peter-mowen/networked-environment-monitor/img/prototype/protoboard-modules.jpg

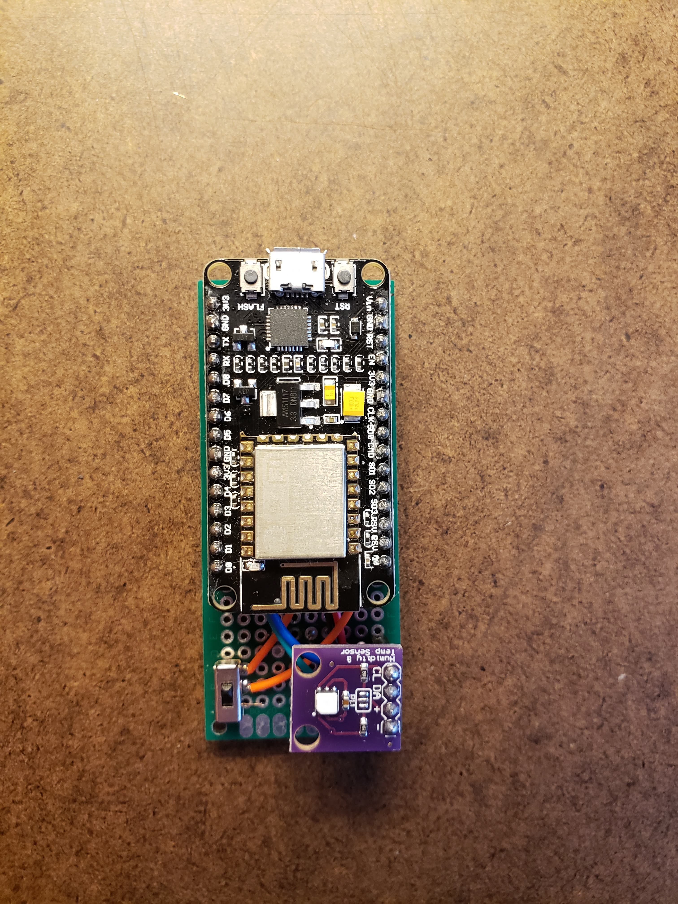
img/prototype/protoboard-modules.jpg
