peter-mowen/networked-environment-monitor/README.md

# Networked Thermometer

## Description
The Networked Thermostater reads the local temperature and reports it via MQTT.

Note that there are a few custom classes in this repository. Eventually, these
will be broken out into their own repos, but for now they are housed here. The
custom classes are:
- HomeNode: handles MQTT
- Si7021: handles I2C communication with si7021 chip. Only supports reading
    temperature at this time
- Thermometer: uses the Si7021 class and Homenode class to read temperature and
    send it via MQTT

NetworkedThermoter.ino calls the setup functions and loop functions for each
class, so the heavy lifting is done in the code for the classes, not the .ino
file.

NetworkedThermoter is setup to turn-on, setup everything, take a temperature
reading and send it via MQTT, then put itself into a deep sleep for 10 minutes,
rinse and repeat.

### Parts
- ESP-12e: microcontroller around which everything is built
- si7021 Humidity and Temperature sensor
- Protoboard
- Wires

### Hardware Setup
Make the following connections between the ESP-12e module and the si7021 module:

| ESP-12e | si7021 |
|:---:|:---:|
| D1 | CL |
| D2 | DA |
| 3.3V | + |
| GND | - |

For deep sleep to work, D0 must be connected to RST. However, this connection
makes it so you cannot load new code onto the module. To get around this, I
added a small SPDT switch with one side connected to D0, the middle connected to
RST, and the other side disconnected. Flipping the switch to one side connects
D0 to RST, while flipping it to the other breaks this connection.

See img/prototype for wiring on breadboard and protoboard.

### Getting Code onto the ESP8266
- Download this repo to your local machine. It will have the custom classes
already included
- Put the NetworkedThermometer folder in your Arduino folder (default location
    is ~/Arduino)
- Open the NetworkedThermoter.ino file with the Arduino IDE
- Add the ESP8266 module to your Arduino IDE
- Connect the ESP-12e module to your computer
- Load the sketch to the ESP-12e using the Arduino IDE

### Dependencies
The following is a list of libraries which this sketch uses as well as a short
description:
- PubSubClient - enable MQTT communication
- Wire - needed for I2C communication

### Node-RED Flows
I used node-RED to create a flow for monitoring the MQTT network and adding
reported temperatures to a database running on a Raspberry Pi. Though that code
is not part of this repository, an image of the user interface can be found in
the img folder.
