peter-mowen/networked-environment-monitor/img/node_red-ui.png

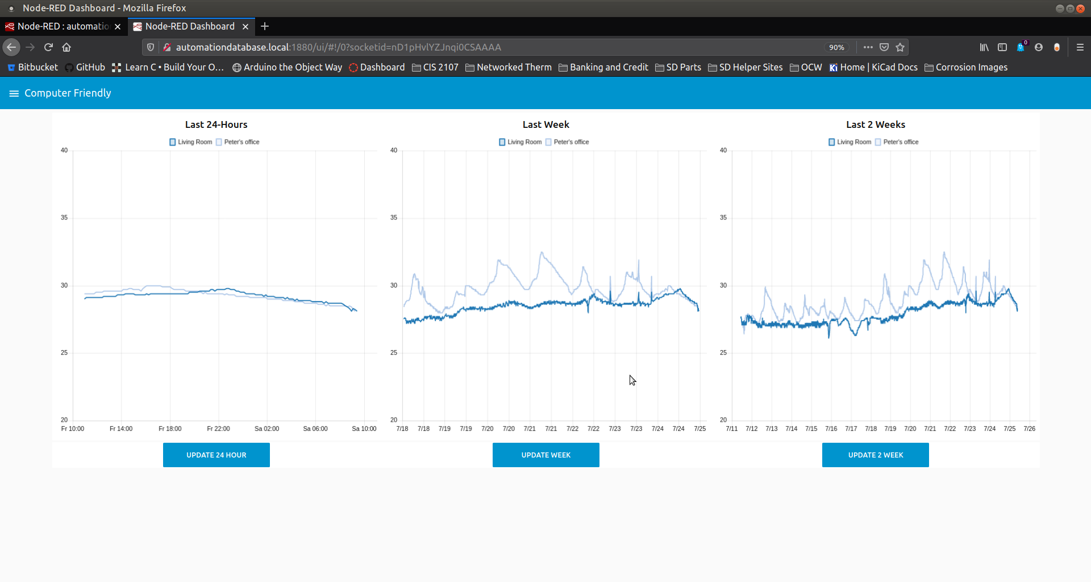
img/node_red-ui.png
