peter-mowen/networked-environment-monitor/img/prototype/breadboard.jpg

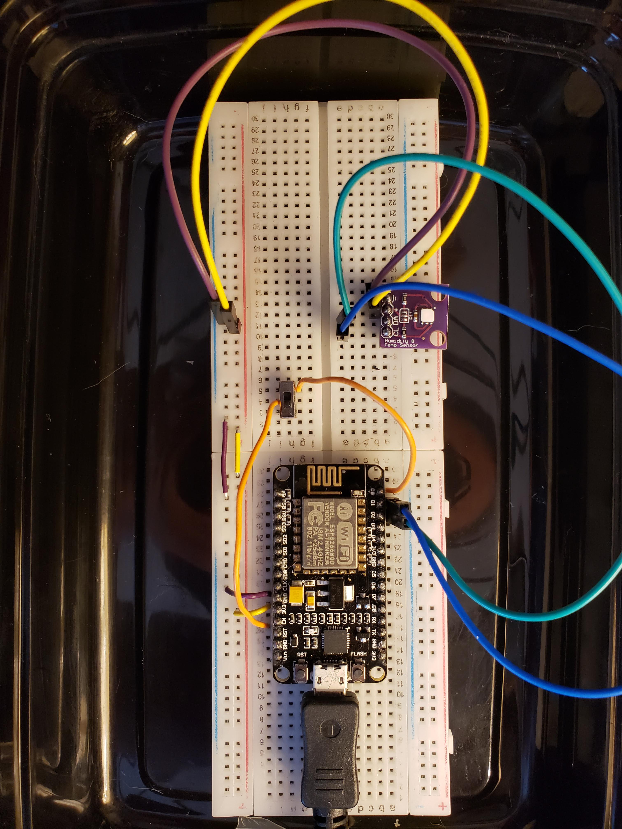
img/prototype/breadboard.jpg
