peter-mowen/networked-environment-monitor/(commit log)

2019-07-24 Initial commit
    Copied code from EnvironmentMonitor and commented out everything related
    to the LDR and LCD. I'm moving development of that project from the
    Arduino to the esp8266-12e. References to the LDR were commented-out for
    the time being until I get a better grasp of the I/Os for the
    esp8266-12e. References to the LCD were commented out because I will
    need to use a different LCD library with the esp8266-12e and having the
    old references breaks the code.
2019-07-24 Fixed accuracy of readTemperature()
    Added an offset for the ADC value. The temperatures read by the
    esp8266-12e were about +5C from the temperatures read by the Arduino.
    After some research, I found that it is a known problem that the ADC on
    NodeMCU's boards are not accurate. To compensate, I setup a voltage
    divider with two 1k resistors and measured the voltage between them.
    It was 1.65V, which is half of 3.3V, which is what I expected. The ADC
    value was 543 when it should have been 512. To find the offset, I took
    543-512 = 31 and defined the ADC_OFFSET to be 31. This brought the
    temperature reading close to what I was seeing on the Arduino.
    Furthermore, I changed readTemperature() to get 1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
    [NetworkedEnvironmentMonitor.ino]
2019-07-25 Deleted printToSerial(.) and added publishData(..)
    Since the networked version of this sketch does not transmit data
    through serial, I removed the function that did that. In its place, I
    wrote a function to publish data to the mqtt broker using pubsubclient.
    I also copied a bunch of code/helper functions from the pubsubclient
    esp8266 example to make it work. Yay plumbing!
    TODO: change inputs to publishData function so that it accepts a
    multidimensional array of topics and data instead of two arguments, one
    for topic and the other for data.
    [NetworkedEnvironmentMonitor.ino]
2019-08-05 Removed references to LCD. Added setup for OLED
    Commented-out everything related to LCD. Copied the include statements,
    constants, and setup portion from the Arducam_ssd1306_128x64_I2C.ino
    example program that came with the library. Changed the position and
    contents of the text so that it will print the clientID name in the
    top portion of the screen where there are yellow pixels.
2019-08-06 Added OLED support for displaying temperature
    Changed printDataToLCD to printDataToOLED in all places. Updated
    function to print data to the OLED. Moved the code to display the
    heading (room name) into the printDataToOLED function since the whole
    display has to be refreshed when the temperature is updated.
2019-08-08 Added code to select channel on multiplexer
    Since the esp8266 has only one analog input, I added a multiplexer IC,
    the cd4051b. The temperature sensor is wired to channel 0. One problem
    I ran into when setting up this chip is that I forgot to wire INH
    (inhibit) to ground so that it would read a zero. Without that, the IC
    does not let channel-in go to channel-out. Used a switch statement to
    set the states of the digital out pins connected to the channel select
    pins on the cd4051b. Added cases for channel 0 and channel 1.
    [NetworkedEnvironmentMonitor.ino]
2019-08-08 Added code to read ldr and calculate resistance
    Added the hardware for the LDR and connected it to channel 1 of the
    cd4051b. Added readLightLevel() to read light level. Added code in setup
    and loop to read and publish the ldr resistance.
2019-08-09 Changed display to round temperature
    Use to truncate temperature, now it rounds it.
2019-08-09 Created loading screen
    Changed boot-up behavior to provide updates on the sceen. It prints
    "Starting.." in the yellow section and a message stating to which
    network it is trying to connect. Will probably not work as expected if
    trying to connect to the wrong network but this is a start.
    [NetworkedEnvironmentMonitor.ino]
2019-08-09 Added IP address to boot-up display
    After the SSID and connecting messages, the device's IP address gets
    printed to the display and stays there for two seconds.
2019-08-09 Added MQTT updates to boot-up display
    Clear the screen by printing a black rectangle to it. Then move the
    cursor back to the top of the blue text block. Lets user know it's
    trying to connect to the mqtt broker at a certain IP address. Lets user
    know when it's connected. Waits 2 seconds.
    [NetworkedEnvironmentMonitor.ino]
2019-08-09 Added error handling for connecting to WiFi
    Set the max number of attempts to 20 because that is how many periods
    will fit across the OLED and I have yet to see it take more than 15.
    Created a function to handle errors called haltOnError. It accepts
    a string, prints it to the serial port, displays the message to the
    screen, then feeds the watchdog forever.
    [NetworkedEnvironmentMonitor.ino]
2019-08-09 Added error handling for connecting to mqtt broker
    Prints message if the board fails to connect to the mqtt broker. Retries
    5 times at 5 second intervals. Passes error message to haltOnError.
    Updated halt on error to clear display, print "ERROR" in the yellow
    text part, and print the error in the blue text part.
    [NetworkedEnvironmentMonitor.ino]
2019-08-09 Added clearAndWriteToTitle(String title)
    Clears the title area by writing a black rectangle to it, then writes
    the title. Text size is set to 2. Changed all places in the code where
    I manually udpated that section of the display to use this new function.
    Causes "Temp:..." to blink in the printDataToOLED function. Hopefully
    that will be fixed by functionalizing the part that writes text to the
    body.
    [NetworkedEnvironmentMonitor.ino]
2019-08-09 Updated multiplexer pin initialization
    Changed setup function so it just sets the pinMode for each multiplexer
    channel pin. The state is set by the readTemperature or readLightLevel
    function.
2019-10-01 Updated code to work with mcp3008
    Replaced all of the multiplexer and ADC code with calls to the mcp3008
    ADC IC. Debugged hardware. Found that because the temperature sensor was
    near the USB cable, it was getting bad readings, except when I connected
    a multimeter to it. Moved it to the other end of the breadboard and the
    mcp3008 is getting accurate readings now.
    [NetworkedEnvironmentMonitor.ino]
2019-10-09 Squashed commits related to documentation
    These are in reverse chronological order from the order in which they
    occured.
    This is the commit message #8:
    Finished documenting functions
    Added comments that explain what the last few functions do.
    This is the commit message #7:
    Updated README
    Realized I forgot to include the screen in my parts list. Added a
    section on future updates.
    This is the commit message #6:
    Added a README
    This is the commit message #5:
    Updating documentation
    WIP: Added comments to beginning of most of the functions. Added
    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
    [NetworkedEnvironmentMonitor.ino]
2020-01-02 Renames main code and updates README
    Renames main code to better reflect what this code actually is. The
    scope of the project changed. Instead of building an environment monitor
    with lots of different sensors, this is just going to be a thermostat.
    Uncommented preprocessor definitions for debugging. Uncommented sections
    of code to allow network connectivity again. Removed SSID, password, and
    MQTT broker address from commit.
    Updated README to reflect changes to project scope. Also added a Build
    Instructions section and a Dependencies section.
2020-01-03 Updates basic Wifi error handling
    Previously, if the thermostat could not connect to wifi, it errored out
    and hung there. Now, if it cannot connect to wifi, it will not attempt
    to connect to the MQTT broker in the setup block and will not try to
    send the temperature to the broker in the loop block. If the wifi is
    connected and the client is connected to the data broker, it will send
    the temperature to the datat broker. It periodically tries to reconnect
    to the wifi network. Adds symbols to show wifi connectivity in the upper
    right-hand corner of the screen based on wifi status from the last time
    it checked. It does not continuously check wifi status.
2020-01-03 Updates error handling for connecting to mqtt
    Previously, if the thermostat could not connect to the mqtt broker, it
    error-ed out after the max attempts had been reached. Now it will retry
    to connect to the mqtt broker at a given interval. If it cannot connect,
    it still reads and displays the temperature. Also added a symbol that
    shows-up on the display to the left of the wifi symbol to show
    whether or not the thermostat is connected to the mqtt broker. Tested
    the following cases:
    - no wifi
    - wifi but no broker
    - connected to wifi and broker disappears
    - connected to wifi and wifi disappears
    The thermostat was able to reconnect to wifi and the mqtt broker if
    either disappeared, then re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
2020-01-06 Adds local thermostat functionality
    Adds the function "setBoiler" that takes a temperature as an input and
    toggles the boiler based on the input temperature, the desired
    temperature, and the upper and lower bounds around the desired
    temperature. It will turn-on the relay pin if the temperature drops
    below the desired temperature minus the lower bound. The relay pin stays
    high until the temperature reaches the desired temperature plus the
    upper bound, then it turns off. It stays off until the temperature drops
    below the desired temperature minus the lower bound.
    Tested this functionality by hard coding a desired temperature based on
    the ambient temperature in the space I was working (it was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
2020-01-07 Changes temperature sensor to SI7021
    Updates code to support the SI7021. Removes the ADC code and the code to
    read the analog thermistor value. Only reading temperature from the
    SI7021 so far. Updates README to reflect this change. Also fixes some
    errors in README referencing this project by its old name.
2020-01-07 Updates network error handling display
    Makes network error handling a little less "in your face." Instead of
    printing detailed messages to the OLED when trying to connect to wifi or
    the MQTT broker:
    - Wifi symbol flashes on and off while trying to connect
    - A question mark appears where the MQTT symbol should be while it
    is attempting to connect.
    To display detailed network troubleshooting messages, one now has to
    uncomment the preprocessor definition DEBUG_NETWORK.
2020-01-07 Adds desired temperature to OLED display
    The desired temperature is now displayed on the OLED. Updates the
    printTempToOLED function to handle more than one location.
2020-01-07 Adds up and down button support
    The preferred temperature can now be set using two buttons.
    Also, fixes a couple of DEGBUG_NETWORK to DEGBUG_NETWORK and adds a few
    lines to the wifi debug block in the loop section.
2020-01-08 Fixes network connectivity bug and adds relay msg
    Puts the reconnect function before testing the mqtt connection. When my
    test period was only 1 second, the ESP would stay connected to the mqtt
    broker between loops. However, once I started doing longer periods, it
    did not. This commit runs the reconnect function before testing the mqtt
    connection status.
    The previous way was confusing because the indicator on the screen said
    that I was connected to mqtt when in fact I was not. So I was very
    confused as to why the mqtt broker was not receiving anything even
    though the screen said the thermostat was connected.
    This commit also adds mqtt messages to indicate the status of the relay
    which impl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
2020-01-08 Updates how and when on-screen temp is updated
    Changes code to update screen once a minute while updating MQTT onces
    every three minutes. Changes temperature to be a global variable, which
    changes how readAmbientTemperature and printTempToOLED work.
2020-01-08 Changes set temperature behavior
    Now when the set temperature changes, the thermostat checks to see if
    the relay needs to be turned on or off. Uncovered bug where I forgot to
    initialize the button states in the setup block.
2020-01-08 Sends preferred temperature to mqtt broker
2020-01-10 Moves network connectivity check inside reconnect
    I was having trouble with the thermostat staying connected to the mqtt
    broker. I found that I had forgotten to include the reconnect/loop
    structure at the top of my loop function. This commit moves the network
    connectivity check inside the reconnect function so that before trying
    to connect to the mqtt broker, it first checks whether or not it is
    connected to wifi. This significantly cleans-up the main loop function.
    Also, this commit changes how some of the debug statements related to
    network connectivity work. I move all of the serial debug print
    statements into their own DEBUG blocks and moved statements that print
    to the OLED into DEBUG_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
2020-03-22 Starts refactor. Adds Thermometer.cpp. Guts .ino
    The original file, NetworkedThermostat.ino has become unreadable so a
    refactor is in order. This commit starts that process. The goal of the
    refactor is to make the code more modular. Since the room nodes will
    share a large code base with the thermostat, it is prudent to refactor
    the code in such a way as to make that easy. At the end of this
    refactor, there will be two main objects: Thermometer and Thermostat.
    This commits starts the Thermometer object. Thermometer.ccp is a class
    file. This commit adds the ability to create a Thermometer object,
    connect the esp8266 to the si7021 chip via I2C, and read the ambient
    temperature. NetworkedThermo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
2020-03-26 Adds getTemperatureVal() to Thermometer.cpp
    Function to retrieve value of the private data member temperature.
    Updates NetworkedThermostat.ino to use this function when printing the
    temperature to serial to test functionality.
2020-03-26 Adds setupSi7021() to Thermometer.cpp
    Adds privat function to setup I2C connection to the si7021 temperature
    sensor. Changed the setup() function to call this function during setup.
2020-03-27 Adds publishing functionality to Thermometer
    Also updates the HomeNode object and .ino file. Biggest thing I learned
    tonight was to use IPAddress instead of const char* when assigning the
    IP address of the MQTT broker. Using the later is unreliable when trying
    to connect to the broker.
    [HomeNode.cpp, Thermometer.cpp]
2020-08-08 Adds new Si7021 object
    New object handles reading temperature from Si7021 to its own object
    instead of making that part of the Thermometer object. Would like to
    eventually update thermometer to support other temperature sensors.
    As long as the sensor objects have a readTemperatureC function, not much
    would have to change in the thermometer object.
2020-08-08 Adds blurb Node-RED Flows to README
    Also adds image of user interface to see temperatures reported by nodes
    running this software.
2021-12-05 Adds header files for custom classes and cleans-up code
    NOTE: I did not run the code for this commit on an esp8266 module. I
    only verified that it compiles. I haven't touched this project in
    almost a year and a half and no longer am running the mqtt/database
    server to which this code connected.
    I wrote these classes before I really understood how header files and
    classes worked. The code ran, so I was happy at the time. Since then,
    I've grown a lot as a programmer so I decided to update this repo to
    reflect that.
    Squashed commit of the following:
    commit c3bd091412a321929d1105203fa8e0519b50a3cd
    Author: Peter Mowen <pmmowen@gmail.com>
    Date: Sun Dec 5 12:37:12 2021 -0500
    Removes comme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
    [HomeNode.cpp, HomeNode.h, NetworkedThermometer.ino, Si7021.cpp, Si7021.h, Thermometer.cpp, Thermometer.h]
