peter-mowen/networked-environment-monitor/img/prototype/protoboard-wiring.jpg

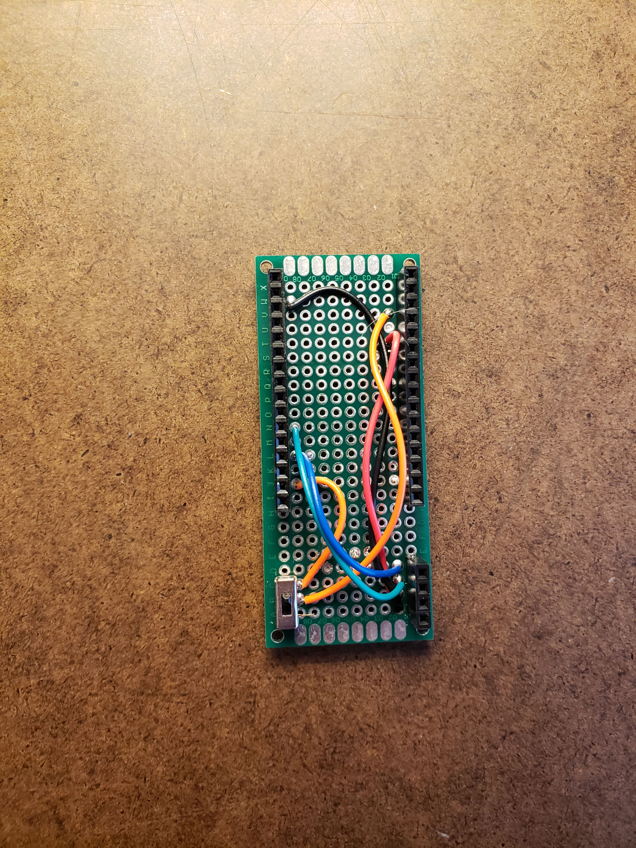
img/prototype/protoboard-wiring.jpg
